roheheth/driver-drowsiness-detection/hardware/bench_prototype.png

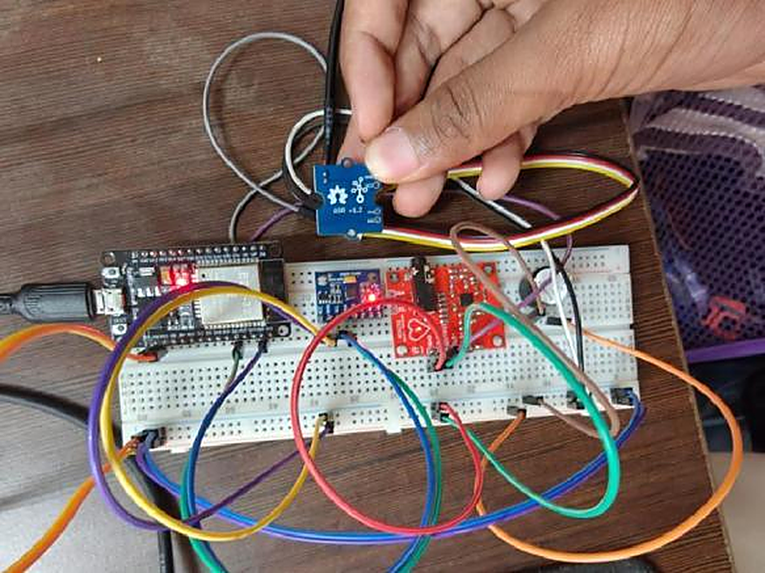
hardware/bench_prototype.png
